frc4343/max2019/mxp-board/parts/bom.xlsx

Description | Name | Qty | Vendor | Vendor P/N | Mfr | Mfr P/N | Price | Comments
Adafruit BNO055 carrier board | BREAKOUT BOARD 9-DOF IMU BNO055 | 1 | Digi-Key | 1528-1426-ND | Adafruit Industries | 2472 | $51.40 | There are other less expensive alternatives
Arduino Nano | ARDUINO NANO BOARD | 1 | Digi-Key | 1050-1001-ND | Arduino | A000005 | $32.35 | Easy to replicate in schematic
Vertical MXP Connector | CONN RCPT 34POS 0.1 GOLD PCB | 0 | Digi-Key | ED3068-ND | On-Shore Technology | SH2-34G-P | $2.32
Elevated Vertical MXP Connector | CONN SOCKET 34POS 0.1 GOLD PCB | 0 | Mouser | 200-ESW11723LD | Samtec | ESW-117-23-L-D | $8.68 | Digi-Key P/N: ESW-117-23-L-D-ND
Board Spacer for Elevated Connector | HEX STANDOFF #4-40 ALUM 3/16" | 2 | Digi-Key | 1772-2031-ND | RAF Electronic Hardware | 4500-440-AL-7 | $0.72 | Use only if elevated connector is used
Board Mount Screws | MACHINE SCREW PAN PHILLIPS 4-40 (Nylon) | 2 | Digi-Key | RPC1579-ND | Essentra Components | NSP-4-3-01 | $0.16 | #4-40 x 3/16"
3-Pin Header | CONN HEADER VERT 3POS 2.54MM | 0 | Digi-Key | 609-3461-ND | Amphenol (FCI) | 68000-103HLF | $0.43 | Not needed
4-Pin Header | CONN HEADER VERT 4POS 2.54MM | 0 | Digi-Key | 609-3305-ND | Amphenol (FCI) | 68002-404HLF | $0.31 | Not needed
