frc4343/max2019/balluff-sensor-adapter/design/Ultiboard Exports/balluff-adapter.dxf

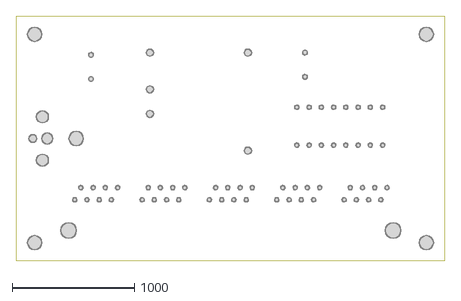
[picture p1: CAD file, 2019-03-01]
balluff-sensor-adapter/design/Ultiboard Exports/balluff-adapter.dxf
3500.0 x 2000.0
