frc4343/max2019/balluff-sensor-adapter/design/balluff-adapter.pdf

⚠
ℹ

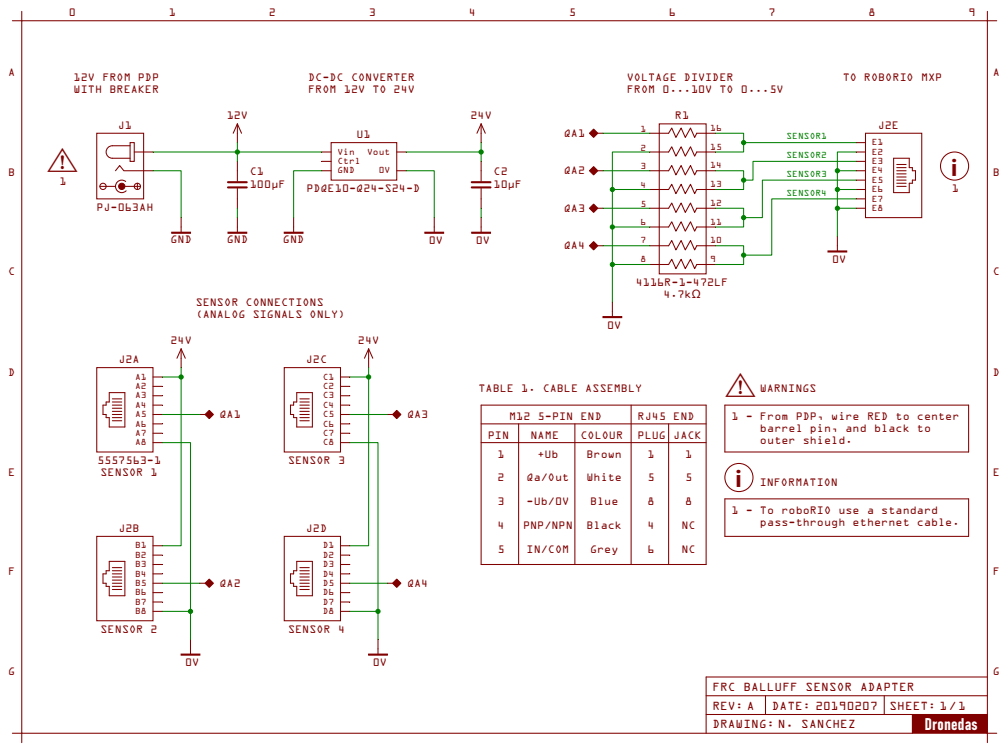
[picture p2: page 1]

1 - From PDP, wire RED to center
barrel pin, and black to
outer shield.
ℹ INFORMATION

PIN | NAME | COLOUR | PLUG | JACK
1 2 3 4 5 | +Ub Qa/Out -Ub/0V PNP/NPN IN/COM | Brown White Blue Black Grey | 1 5 8 4 6 | 1 5 8 NC NC

1 - To roboRIO use a standard
pass-through ethernet cable.

FRC BALLUFF SENSOR ADAPTER
