frc4343/max2019/mxp-board/design/roborio-mxp.pdf

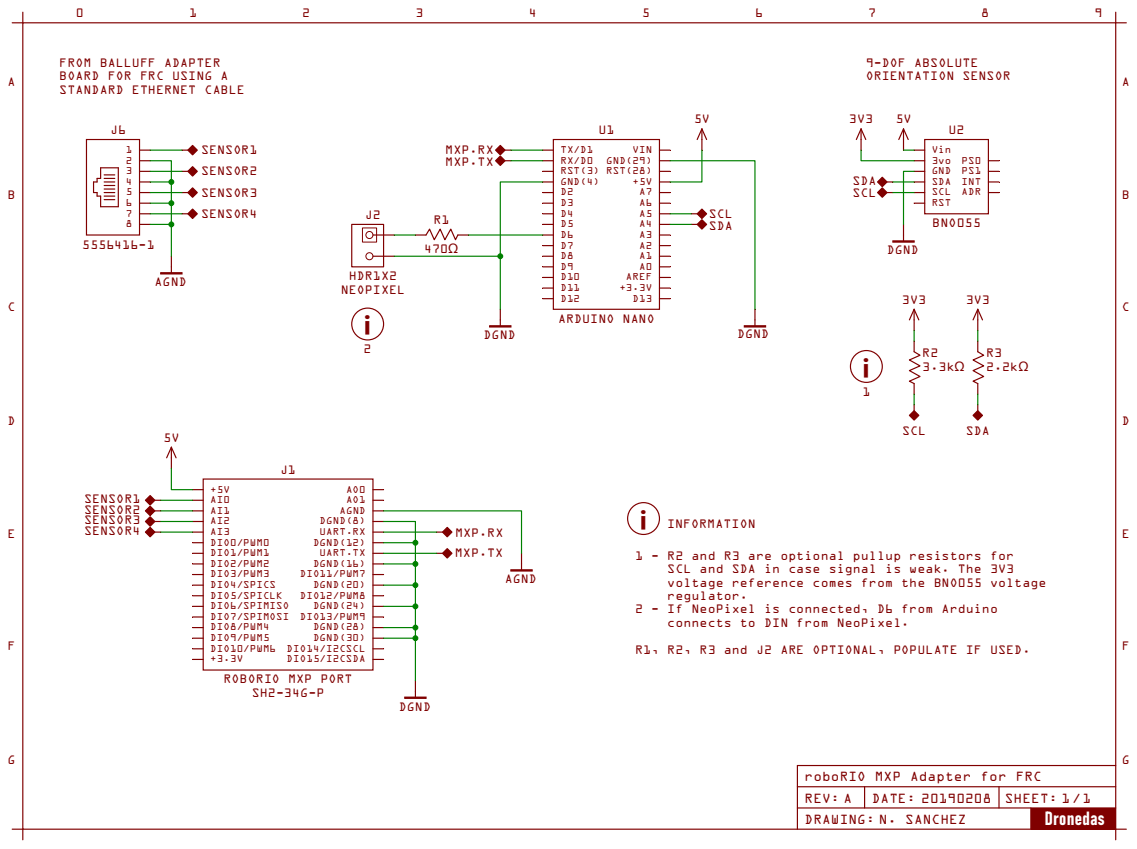
[picture p3: page 1]

FROM BALLUFF ADAPTER
BOARD FOR FRC USING A
STANDARD ETHERNET CABLE

1 - R2 and R3 are optional pullup resistors for
SCL and SDA in case signal is weak. The 3V3
voltage reference comes from the BNO055 voltage
regulator.
2 - If NeoPixel is connected, D6 from Arduino
connects to DIN from NeoPixel.

R1, R2, R3 and J2 ARE OPTIONAL, POPULATE IF USED.

roboRIO MXP Adapter for FRC
