frc4343/max2019/balluff-sensor-adapter/parts/5556416-1.pdf

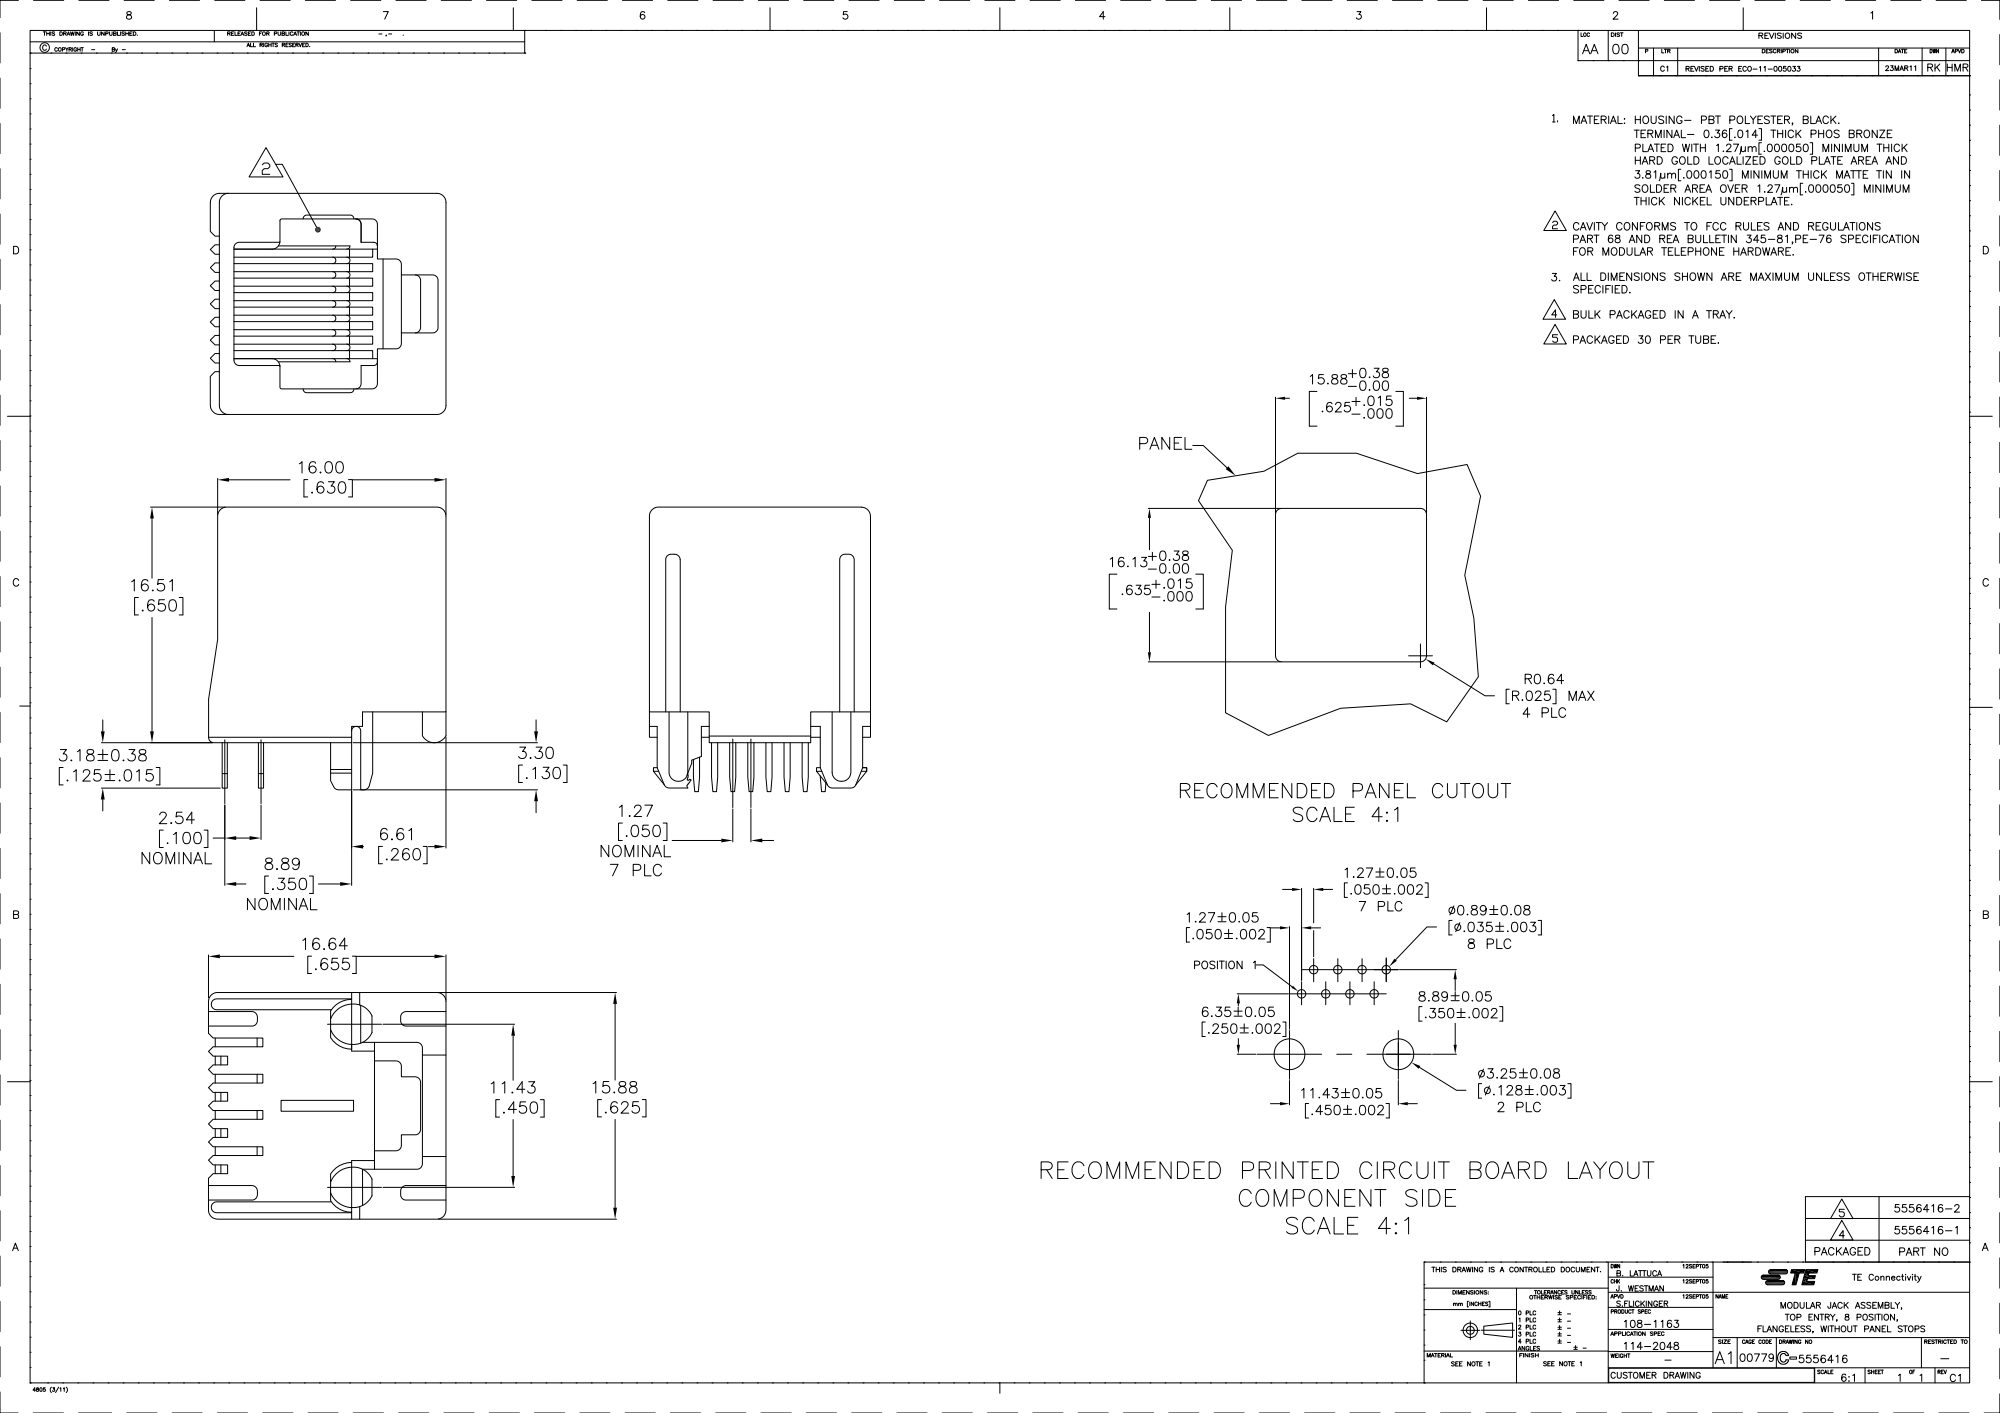
[picture p4: page 1]
