frc4343/max2019/balluff-sensor-adapter/parts/5557563-1.pdf

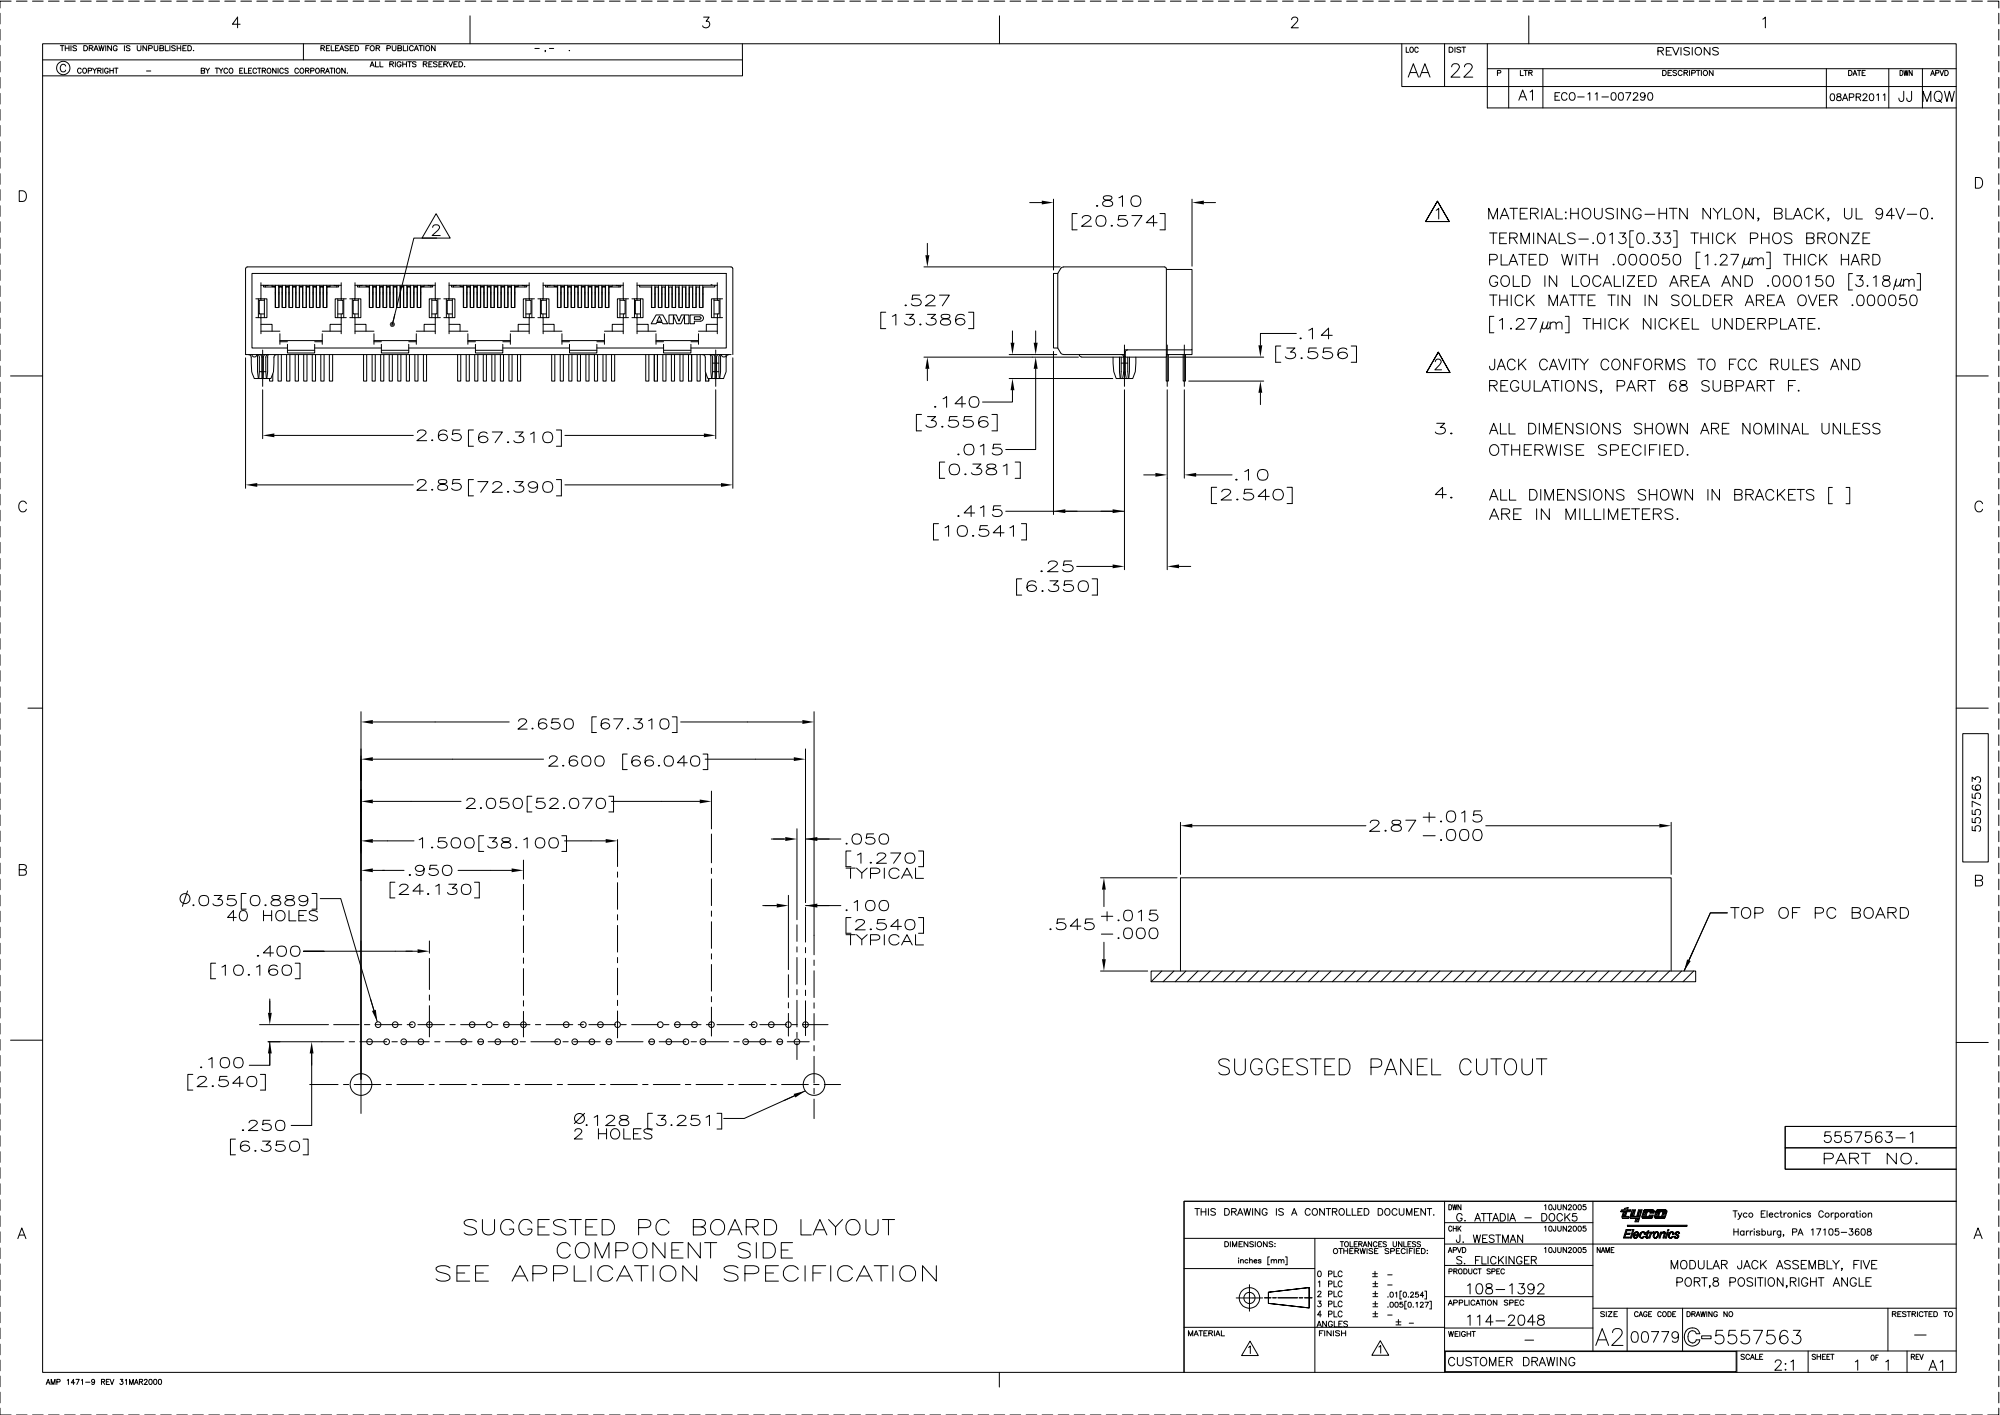
[picture p5: page 1]
