frc4343/max2019/balluff-sensor-adapter/parts/SH2-34G-P.pdf

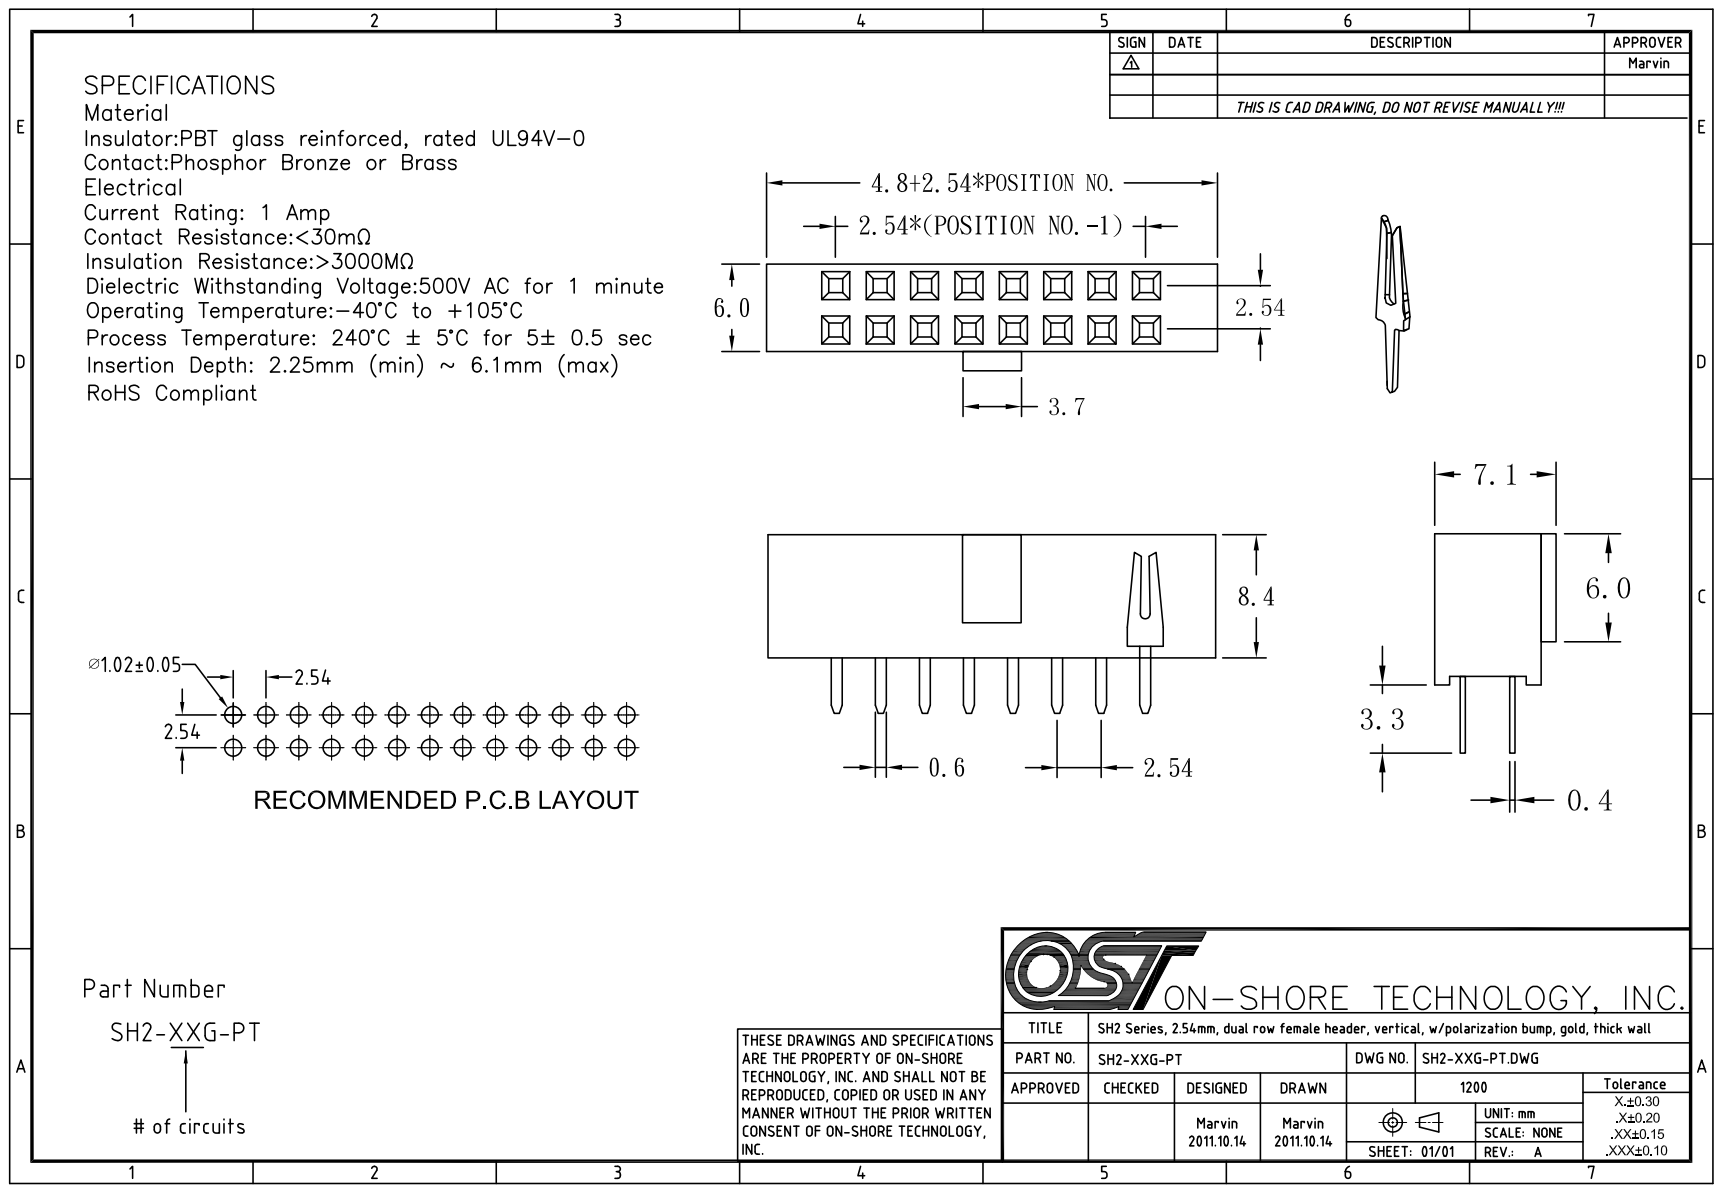
[picture p6: page 1]
