frc4343/max2019/(list of files, drawings)

Other design files:
balluff-sensor-adapter/design/balluff-adapter.ms14
mxp-board/design/roborio-mxp.ms14
